mar0x/midi_controller/cad/case.FCStd

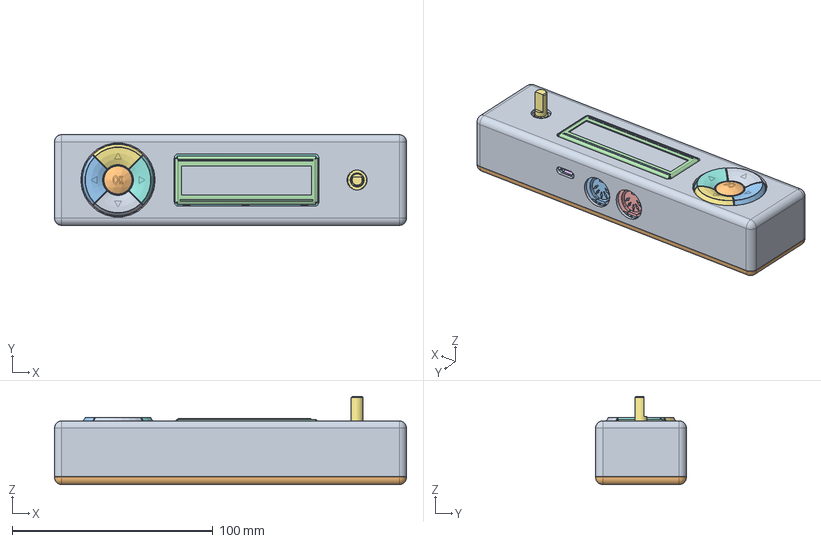
[picture p1: CAD file, 2026-05-28]
cad/case.FCStd
175.2 x 45.2 x 43.9 mm
top_case
bottom_cover
R_0805_2012Metric
R_0805_2012Metric001
R_0805_2012Metric002
R_0805_2012Metric003
R_0805_2012Metric004
micro board
MICRO_stackable header 12
MICRO_stackable header pin
MICRO_stackable header pin001
MICRO_stackable header pin002
MICRO_stackable header pin003
MICRO_stackable header pin004
MICRO_stackable header pin005
MICRO_stackable header pin006
MICRO_stackable header pin007
MICRO_stackable header pin008
MICRO_stackable header pin009
MICRO_stackable header pin010
MICRO_stackable header pin011
micro usb shell
micro usb internal
micro usb contact
micro usb contact001
micro usb contact002
micro usb contact003
micro usb contact004
atmega32U4
MICRO_cap106C
MICRO_cap106C001
MICRO_stackable header 002
MICRO_stackable header pin012
MICRO_stackable header pin013
MICRO_stackable header pin014
MICRO_stackable header pin015
MICRO_stackable header pin016
MICRO_stackable header pin017
MICRO_stackable header pin018
MICRO_stackable header pin019
MICRO_stackable header pin020
MICRO_stackable header pin021
MICRO_stackable header pin022
MICRO_stackable header pin023
micro_crystal 5x3
micro_MIC5219
MICRO_603 resistor 103
MICRO_603 resistor 104
MICRO_603 resistor 105
MICRO_603 resistor 106
MICRO_603 resistor 102
MICRO_603 resistor 108
MICRO_603 resistor 109
MICRO_603 resistor 110
MICRO_603 resistor 22
MICRO_603 resistor 112
MICRO_603 resistor 113
MICRO_603 resistor 114
MICRO_603 resistor 116
MICRO_603 resistor 117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
