mar0x/midi_controller/stl/case-bottom_cover.stl

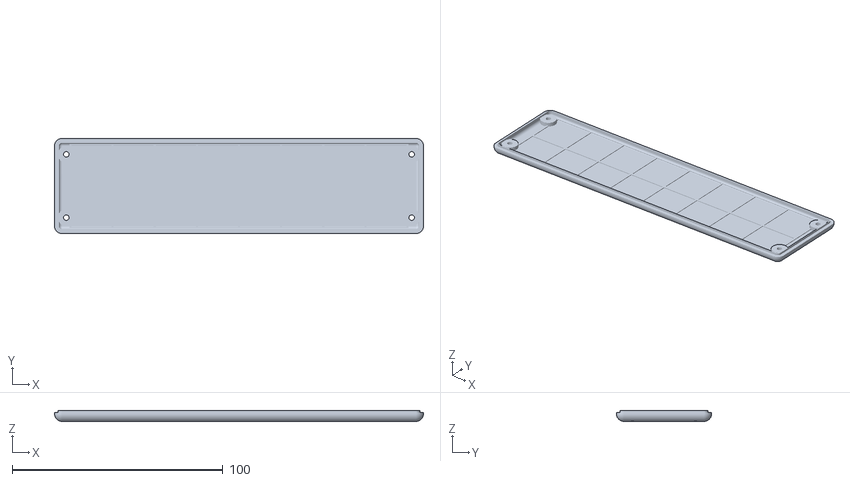
[picture p2: CAD file, 2026-05-28]
stl/case-bottom_cover.stl
175.2 x 45.2 x 5.10
