mar0x/midi_controller/stl/case-top_case.stl

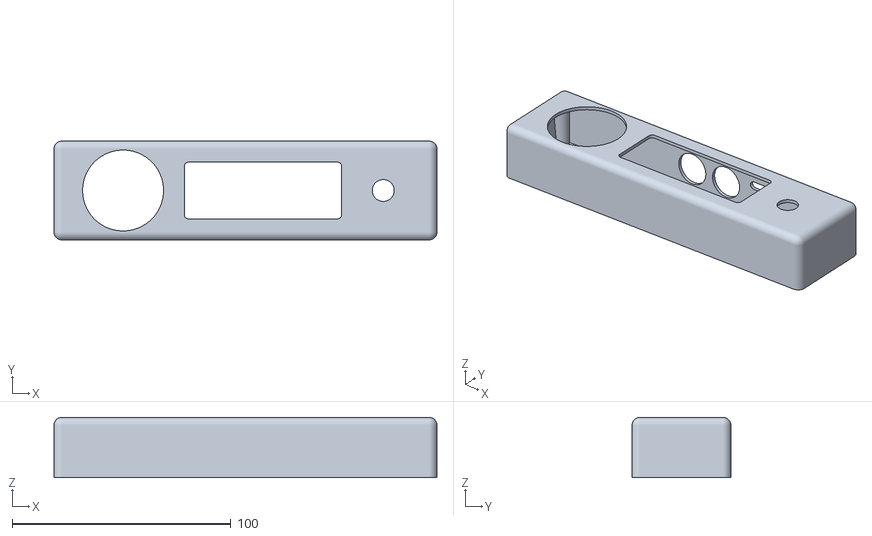
[picture p3: CAD file, 2026-05-28]
stl/case-top_case.stl
175.2 x 45.2 x 27.6
