mar0x/midi_controller/kicad/5-way-button-board/5-way-button-board.kicad_pcb

## KiCad design kicad/5-way-button-board/5-way-button-board.kicad_pcb (2026-05-29)

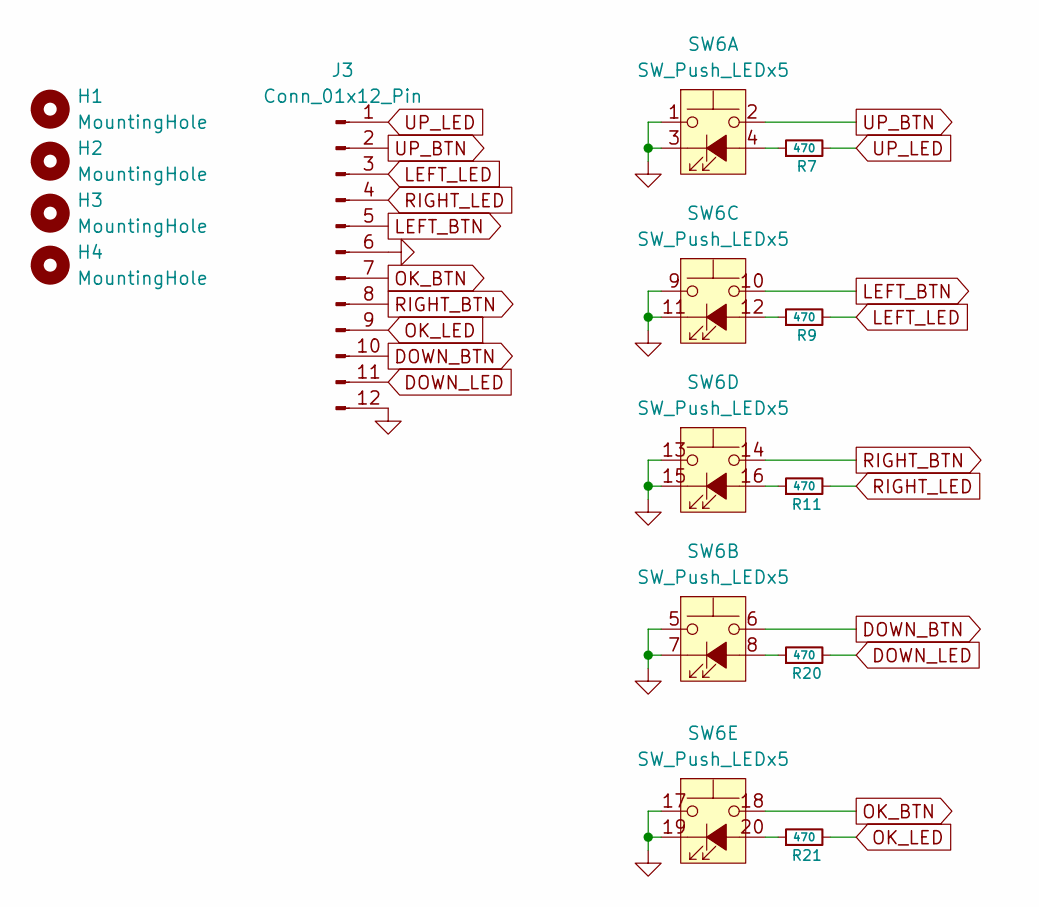
[picture p4: schematic 5-way-button-board.kicad_sch]

Parts:
H1, H2, H3, H4: MountingHole; MountingHole_3.2mm_M3_DIN965
J3: Conn_01x12_Pin; PinHeader_1x12_P2.54mm_Vertical
R7, R9, R11, R20, R21: 470; R_0805_2012Metric_Pad1.20x1.40mm_HandSolder
SW6: SW_Push_LEDx5; SW_PUSH_12mm_LEDx5

Connections:
DOWN_BTN: J3.10, SW6.6
DOWN_LED: J3.11, R20.2
GND: J3.6, J3.12, SW6.1, SW6.3 (K), SW6.5, SW6.7 (K), SW6.9, SW6.11 (K), SW6.13, SW6.15 (K), SW6.17, SW6.19 (K)
LEFT_BTN: J3.5, SW6.10
LEFT_LED: J3.3, R9.2
unnamed: R7.1, SW6.4 (A)
unnamed: R20.1, SW6.8 (A)
unnamed: R9.1, SW6.12 (A)
unnamed: R11.1, SW6.16 (A)
unnamed: R21.1, SW6.20 (A)
OK_BTN: J3.7, SW6.18
OK_LED: J3.9, R21.2
RIGHT_BTN: J3.8, SW6.14
RIGHT_LED: J3.4, R11.2
UP_BTN: J3.2, SW6.2
UP_LED: J3.1, R7.2

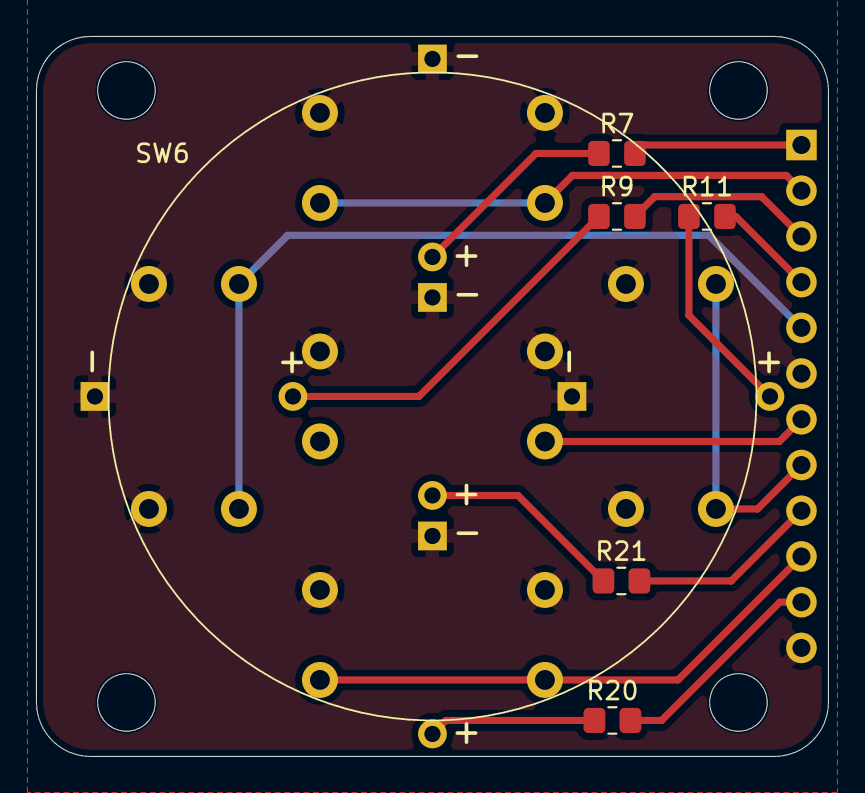
[picture p5: board 5-way-button-board.kicad_pcb from above]

Board: 2 copper layers, 44.0 x 40.0 mm, 11 parts (1 on the bottom side), 16 nets.
