mar0x/midi_controller/kicad/midi_pro_micro/midi_pro_micro.kicad_pcb

## KiCad design kicad/midi_pro_micro/midi_pro_micro.kicad_pcb (2026-05-29)

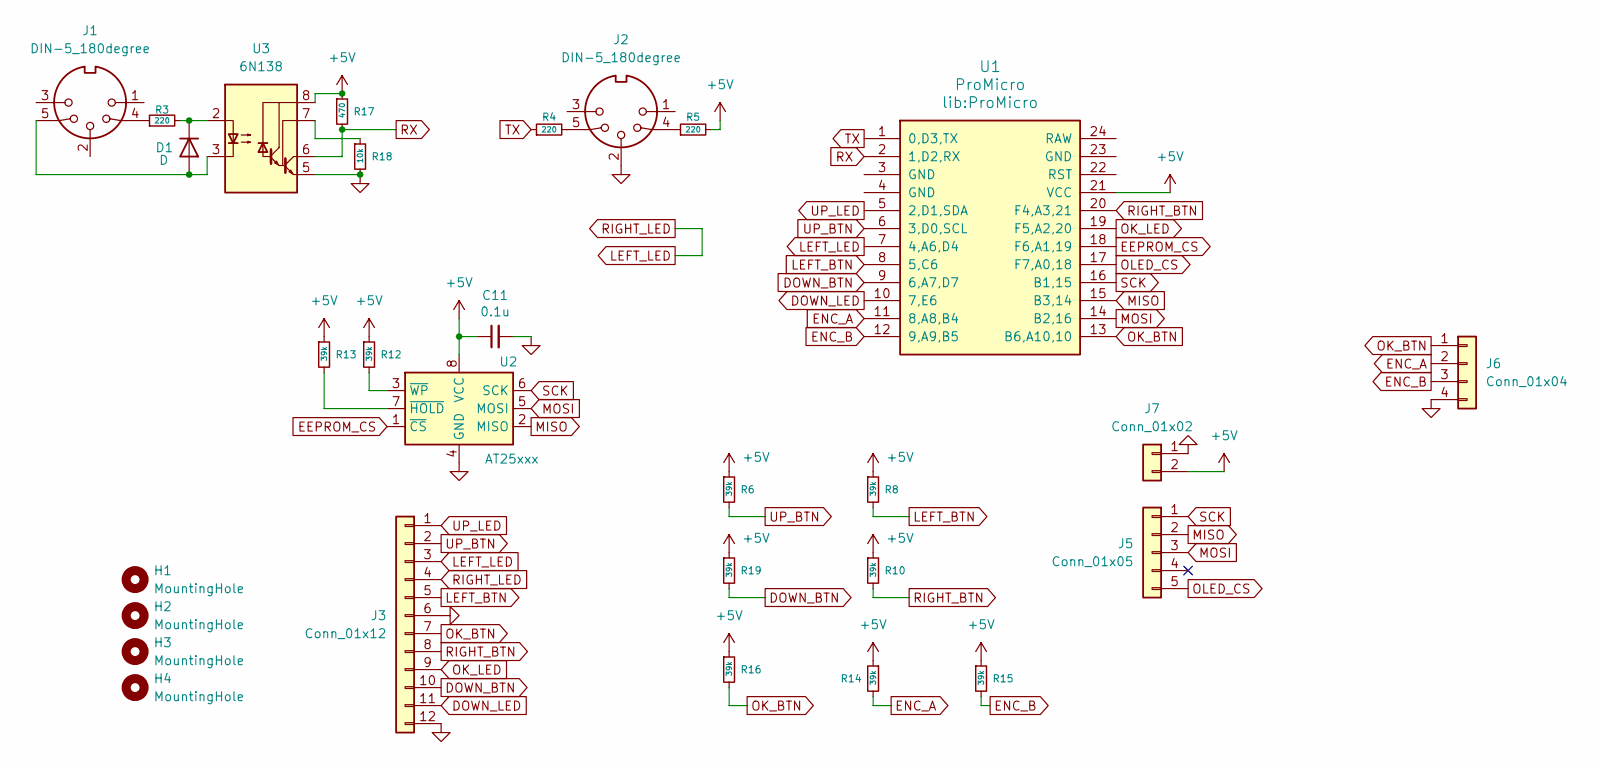
[picture p6: schematic midi_pro_micro.kicad_sch]

Parts:
C11: 0.1u; C_0805_2012Metric
D1: D; D_SOD-323_HandSoldering
H1, H2, H3, H4: MountingHole; MountingHole_3.2mm_M3_DIN965
J1, J2: DIN-5_180degree; DIN5MIDI-OOTDTY
J3: Conn_01x12; SW_PUSH_12mm_LEDx5_BOARD
J5: Conn_01x05; JST_PH_B5B-PH-K_1x05_P2.00mm_Vertical
J6: Conn_01x04; Encoder_BOARD-30x40
J7: Conn_01x02; JST_PH_B2B-PH-K_1x02_P2.00mm_Vertical
R3, R4, R5: 220; R_0805_2012Metric_Pad1.20x1.40mm_HandSolder
R6, R8, R10, R12, R13, R14, R15, R16, R19: 39k; R_0805_2012Metric_Pad1.20x1.40mm_HandSolder
R17: 470; R_0805_2012Metric_Pad1.20x1.40mm_HandSolder
R18: 10k; R_0805_2012Metric_Pad1.20x1.40mm_HandSolder
U1: ProMicro
U2: AT25xxx; SO-8_3.9x4.9mm_P1.27mm
U3: 6N138; DIP-8_W7.62mm_Socket

Connections:
+5V: C11.1, J7.2, R5.2, R6.1, R8.1, R10.1, R12.1, R13.1, R14.1, R15.1, R16.1, R17.1, R19.1, U1.21 (VCC), U2.8 (VCC), U3.8 (VCC)
DOWN_BTN: J3.10, R19.2, U1.9 (6,A7,D7)
DOWN_LED: J3.11, U1.10 (7,E6)
EEPROM_CS: U1.18 (F6,A1,19), U2.1 (~CS)
ENC_A: J6.2, R14.2, U1.11 (8,A8,B4)
ENC_B: J6.3, R15.2, U1.12 (9,A9,B5)
GND: C11.2, J2.2, J3.6, J3.12, J6.4, J7.1, R18.2, U2.4 (GND), U3.5 (GND)
LEFT_BTN: J3.5, R8.2, U1.8 (5,C6)
LEFT_LED: J3.3, J3.4, U1.7 (4,A6,D4)
MISO: J5.2, U1.15 (B3,14), U2.2 (MISO)
MOSI: J5.3, U1.14 (B2,16), U2.5 (MOSI)
unnamed: D1.2 (A), J1.5, U3.3 (C2)
unnamed: D1.1 (K), R3.2, U3.2 (C1)
unnamed: J1.4, R3.1
unnamed: J2.4, R5.1
unnamed: J2.5, R4.2
unnamed: R13.2, U2.7 (~HOLD)
unnamed: R12.2, U2.3 (~WP)
unnamed: R18.1, U3.7 (VO1)
OK_BTN: J3.7, J6.1, R16.2, U1.13 (B6,A10,10)
OK_LED: J3.9, U1.19 (F5,A2,20)
OLED_CS: J5.5, U1.17 (F7,A0,18)
RIGHT_BTN: J3.8, R10.2, U1.20 (F4,A3,21)
RX: R17.2, U1.2 (1,D2,RX), U3.6 (VO2)
SCK: J5.1, U1.16 (B1,15), U2.6 (SCK)
TX: R4.1, U1.1 (0,D3,TX)
UP_BTN: J3.2, R6.2, U1.6 (3,D0,SCL)
UP_LED: J3.1, U1.5 (2,D1,SDA)

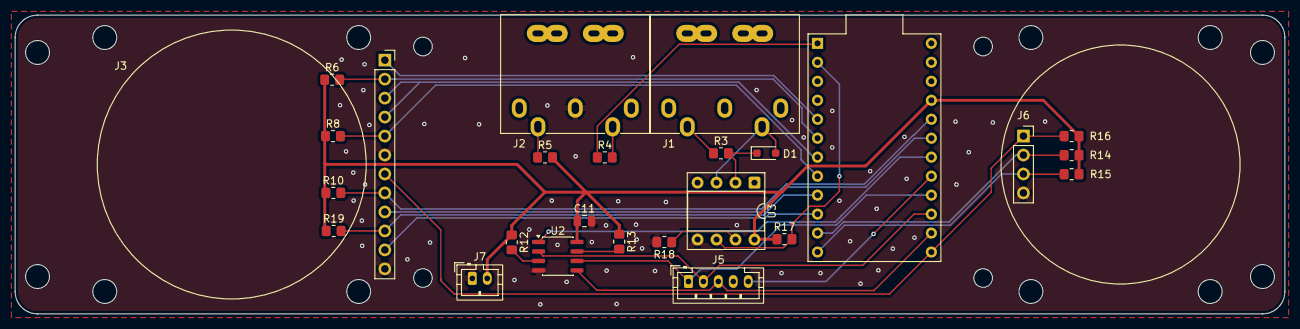
[picture p7: board midi_pro_micro.kicad_pcb from above]

Board: 2 copper layers, 170.0 x 40.0 mm, 30 parts (0 on the bottom side), 28 nets.

Other parts of the board:
H11: Conn_01x16_Pin; OLED_1602_mechanical
