mar0x/midi_controller/kicad/encoder-board/encoder-board.kicad_pcb

## KiCad design kicad/encoder-board/encoder-board.kicad_pcb (2026-05-29)

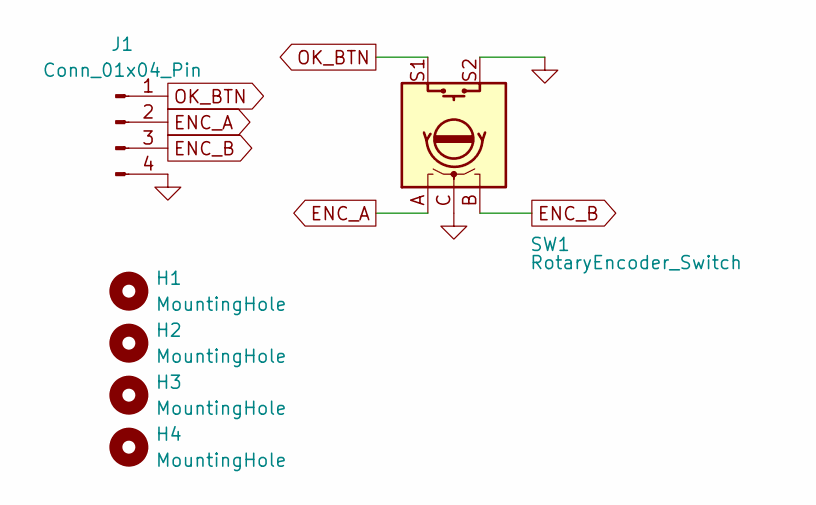
[picture p8: schematic encoder-board.kicad_sch]

Parts:
H1, H2, H3, H4: MountingHole; MountingHole_3.2mm_M3_DIN965
J1: Conn_01x04_Pin; PinHeader_1x04_P2.54mm_Vertical
SW1: RotaryEncoder_Switch; RotaryEncoder_Bourns_Vertical_PEC12R-3x17F-Sxxxx

Connections:
ENC_A: J1.2, SW1.A
ENC_B: J1.3, SW1.B
GND: J1.4, SW1.C, SW1.S2
OK_BTN: J1.1, SW1.S1

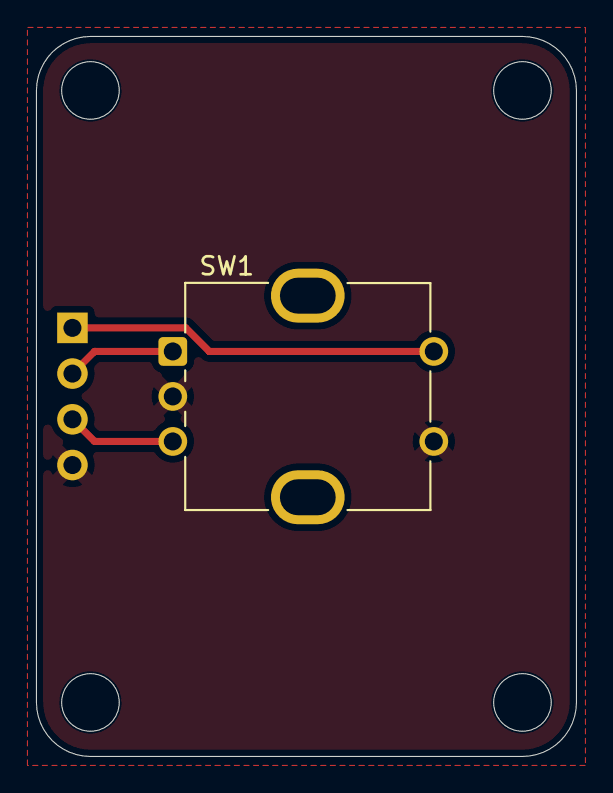
[picture p9: board encoder-board.kicad_pcb from above]

Board: 2 copper layers, 30.0 x 40.0 mm, 6 parts (1 on the bottom side), 4 nets.
