mar0x/midi_controller/firmware/serial_cmd.cpp

#include "serial_cmd.h"
#include "debug.h"

#include <avr/pgmspace.h>

namespace midi_controller {

void
serial_cmd_t::read(uint8_t b) {
    if (b == '\n' || b == '\r') {
        buf_[size_] = 0;

        parse();
        ready_ = true;

        return;
    }

    if (size_ >= MAX_SIZE) {
        return;
    }

    buf_[size_++] = b;
}

void
serial_cmd_t::parse() {
    arg_size_ = 0;
    arg *a = &arg_[0];
    char in_quote = 0;

    a->start = 0;

    for (uint8_t i = 0; i < size_; i++) {
        char b = buf_[i];

        if (b == '"' && i == a->start) {
            a->start = i + 1;
            in_quote = b;
            continue;
        }

        if (in_quote && in_quote == b) {
            a->end = i;

            debug(7, "arg #", arg_size_, ", start ", a->start, ", end ", a->end);
            //log_window::println("arg #", arg_size_, ", start ", a->start, ", end ", a->end);

            arg_size_++;
            a++;

            a->start = i + 1;
            in_quote = 0;

            if (arg_size_ >= MAX_ARGS) {
                return;
            }
        }

        if (in_quote == 0 && (b == ' ' || b == '\t')) {
            if (i == a->start) {
                a->start = i + 1;
                continue;
            }

            a->end = i;

            //log_window::println("arg #", arg_size_, ", start ", a->start, ", end ", a->end);

            arg_size_++;
            a++;

            a->start = i + 1;

            if (arg_size_ >= MAX_ARGS) {
                return;
            }
        }
    }

    if (a->start < size_) {

        a->end = size_;

        //log_window::println("arg #", arg_size_, ", start ", a->start, ", end ", a->end);

        arg_size_++;
    }

    if (arg_size_ > 0) {
        a = &arg_[0];
        char *b = &buf_[a->start];

        switch (a->end - a->start) {
        case 1:
            if (b[0] == 'V') { command_ = SCMD_VERSION; }
            //if (b[0] == 'E') { command_ = SCMD_ECHO; }
            if (b[0] == 'B') { command_ = SCMD_BTN_PRESS; }
            if (b[0] == 'H') { command_ = SCMD_BTN_HOLD; }
            if (b[0] == 'D') { command_ = SCMD_DISPLAY_DUMP; }
            if (b[0] == '?') { command_ = SCMD_HELP; }
            break;

        case 2:
            //if (b[0] == 'D' && b[1] == 'L') { command_ = SCMD_DEBUG_LEVEL; }
            //if (b[0] == 'F' && b[1] == 'R') { command_ = SCMD_FACTORY_RESET; }
            //if (b[0] == 'H' && b[1] == 'C') { command_ = SCMD_HIDE_CURSOR_DELAY; }
            //if (b[0] == 'F' && b[1] == 'W') { command_ = SCMD_FIRMWARE; }
            //if (b[0] == 'H' && b[1] == 'W') { command_ = SCMD_HARDWARE; }
            //if (b[0] == 'M' && b[1] == 'D') { command_ = SCMD_MODE; }
            if (b[0] == 'M' && b[1] == 'F') { command_ = SCMD_MIDI_FORWARD; }
            //if (b[0] == 'M' && b[1] == 'O') { command_ = SCMD_MIDI_PROG_OUT; }
            //if (b[0] == 'N' && b[1] == 'M') { command_ = SCMD_NAME; }
            if (b[0] == 'P') {
                if (b[1] == 'C') { command_ = SCMD_PROGRAM_CHANGE; }
                if (b[1] == 'F') { command_ = SCMD_PROFILE; }
                if (b[1] == 'R') { command_ = SCMD_PROGRAM; }
                if (b[1] == 'S') { command_ = SCMD_PROGRAM_START; }
            }
            //if (b[0] == 'R' && b[1] == 'S') { command_ = SCMD_RESTORE; }
            if (b[0] == 'S' && b[1] == 'N') { command_ = SCMD_SERIAL_NUMBER; }
            //if (b[0] == 'S' && b[1] == 'T') { command_ = SCMD_STORE; }
            if (b[0] == 'C' && b[1] == 'S') { command_ = SCMD_CHANNEL_START; }
            if (b[0] == 'M' && b[1] == 'C') { command_ = SCMD_MIDI_CHANNEL; }
            if (b[0] == 'D' && b[1] == 'T') { command_ = SCMD_DEVICE_TITLE; }
            if (b[0] == 'F' && b[1] == 'D') { command_ = SCMD_FACTORY_DATA; }
            break;
/*
        case 3:
            if (b[0] == 'M' && b[1] == 'M' && b[2] == 'I') { command_ = SCMD_MIDI_MON_IN; }
            if (b[0] == 'M' && b[1] == 'M' && b[2] == 'O') { command_ = SCMD_MIDI_MON_OUT; }
            if (b[0] == 'M' && b[1] == 'D' && b[2] == 'S') { command_ = SCMD_MIDI_DUMP_SEND; }
            if (b[0] == 'M' && b[1] == 'D' && b[2] == 'R') { command_ = SCMD_MIDI_DUMP_RECV; }
            break;
*/
        }
    }
}


static const char help_[] PROGMEM = R"HELP(
 MIDI Simulation:
PC [<F> [<P>]] - program change

 Current state change:
PR [<F> [<P> [<NAME> [<S>]]]]
PF [<F> [<NAME> [<C> <P>]]]

 Simulation:
D [MS] - display dump

 Settings:
MC [<C>] - MIDI in channel
PS [1/0] - program start
CS [1/0] - channel start
DT [<T>] - device title
V - show version
)HELP";

/*
NM [<NAME>] - name change
MD [<MODE>] - mode change
ST - store changes
RS - restore
MDS - MIDI Dump Send
MDR - MIDI Dump Receive

B [L/R/U/D/S] - button press

MO [1/0] - MIDI out program change
MF [1/0] - MIDI forwarding
DL [<L>] - debug level
HC [<s>] - hint delay
E [1/0] - echo

FR <V> - factory reset
*/

}
