mar0x/midi_controller/(commit log)

2026-04-11 Starting MIDI controller board
    [midi_pro_micro.kicad_pcb, midi_pro_micro.kicad_sch]
2026-04-12 Draft schematic
    [midi_pro_micro.kicad_pcb, midi_pro_micro.kicad_sch]
2026-04-15 Removing MIDI IN
    [midi_pro_micro.kicad_pcb, midi_pro_micro.kicad_sch]
2026-05-21 Add MIDI IN once again
    [midi_pro_micro.kicad_pcb, midi_pro_micro.kicad_sch]
2026-05-24 Add 5-way button symbol
    [midi_pro_micro.kicad_pcb, midi_pro_micro.kicad_sch]
2026-05-25 5-way-button board
    [5-way-button-board.kicad_pcb, 5-way-button-board.kicad_sch, midi_pro_micro.kicad_pcb, midi_pro_micro.kicad_sch]
2026-05-26 Add encoder board
    [5-way-button-board.kicad_pcb, 5-way-button-board.kicad_sch, encoder-board.kicad_pcb, encoder-board.kicad_sch, midi_pro_micro.kicad_pcb, midi_pro_micro.kicad_sch]
2026-05-26 Add 2.42 OLED display
    [midi_pro_micro.kicad_pcb, midi_pro_micro.kicad_sch]
2026-05-27 Add case body prototype
    [case.FCStd, midi_pro_micro.kicad_pcb, midi_pro_micro.kicad_sch]
2026-05-28 Basic layout ready
    [case.FCStd, midi_pro_micro.kicad_pcb, midi_pro_micro.kicad_sch]
2026-05-28 Start PCB trace
    [case-bottom_cover.stl, case-top_case.stl, case.FCStd, midi_pro_micro.kicad_pcb, midi_pro_micro.kicad_sch]
2026-05-28 PCB trace finished
    [5-way-button-board.kicad_pcb, encoder-board.kicad_pcb, midi_pro_micro.kicad_pcb, midi_pro_micro.kicad_sch]
2026-05-29 Boards fabrication
    [5-way-button-board-B_Cu.gbr, 5-way-button-board-B_Mask.gbr, 5-way-button-board-B_Paste.gbr, 5-way-button-board-B_Silkscreen.gbr, 5-way-button-board-Edge_Cuts.gbr, 5-way-button-board-F_Cu.gbr, 5-way-button-board-F_Mask.gbr, 5-way-button-board-F_Paste.gbr]
2026-06-20 Encoder improvements
2026-06-28 Mobius program switch
